olizeii/cockautomat/(commit log)

2026-10-17 Boxautomat 2.0: Arduino-Sketch, robuste Python-GUI, Installer und Tests
    - Arduino: MPU-6050 Schlagerkennung mit Peak-Fenster, Sperrzeit und Schwerkraft-Kompensation
    - Python: Zustandsautomat, Video-Loop mit Standbild beim Ergebnis, Ready-Overlay
    - USB-Verbindung im Hintergrund-Thread mit automatischem Reconnect
    - Logging in Datei statt print (behebt BrokenPipe/I/O-Abstürze)
    - install.sh, Starter, config.toml, pytest + GitHub Actions
    Claude-Session: https://claude.ai/code/session_01RWxiKtYJDPk6qvJvUJQxqo
    [app.py, boxautomat_sensor.ino, config.py, game.py, highscores.py, protocol.py, serial_link.py]
2026-10-17 Neues Idle-Video und überarbeitete Retro-Oberfläche
    - Idle-Video ersetzt (Pixel-Boxer im CRT-Rahmen, ohne Ton)
    - video_fit = contain: ganzes Video sichtbar, Titel/HUD in den Rändern
    - Ergebnis: LED-Panel mit Leuchten, Mosaik-Hintergrund mit Strahlen,
    Funken, segmentierter Kraftbalken mit Rekordmarke, Bewertung, Konfetti
    - Scoreboard im Synthwave-Look, letzter Schlag markiert
    - CRT-Overlay (Scanlines, Vignette), abschaltbar mit crt_effect
    - ArcadeClassic-Zeichen einzeln gesetzt (T/L-Laufweite)
2026-10-17 Einfachen Arduino-Sketch mit MPU6050-Bibliothek ergänzen
    Separate Alternative zu boxautomat_sensor: ±16 g, Ruhelage-Kalibrierung,
    Peak-Erkennung mit Sperrzeit, genau eine Zahl 1–999 pro Schlag.
2026-10-20 Sensor-Kalibrierung mit EEPROM und Kalibrier-Bildschirm
    Firmware 2.1:
    - Schwelle und 999-Punkte-Wert werden kalibriert und im EEPROM gespeichert
    - startet automatisch bei leerem EEPROM, per 6x Schalterkippen oder Befehl k
    - Ablauf Ruhe -> 3x leicht -> 3x hart, Ablehnung bei Bewegung / zu schwach
    - Übersteuerung (Achse am Anschlag) wird erkannt und gemeldet
    - Live-Stream, Abtastrate, Temperatur und Lage während der Kalibrierung
    App:
    - neue Protokollzeilen CFG und CAL, H mit Clip-Flag
    - Kalibrier-Bildschirm mit Live-Kurve, Messwerten, alten/neuen Werten
    und Warnung, wenn der Sensor näher ans Scharnier muss
    - Taste K startet/abbricht, mit --no-serial als Demo-Ablauf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
2026-11-01 Firmware 3.0: ESP32-S3 mit H3LIS331 (±100/200/400 g)
    - Sensor H3LIS331 direkt per I2C (1000 Hz, nur neue Messwerte), Messbereich RANGE_G
    - Kalibrierwerte im Flash (Preferences) statt EEPROM, Grenzen am Messbereich
    - Pins: I2C SDA 8 / SCL 9, Schalter GPIO 10; USB CDC ohne Blockieren
    - CFG meldet den Messbereich, '?' liefert READY/CFG/Schalter (natives USB resettet nicht)
    - App: Übersteuerung und Skala am gemeldeten Messbereich, Kurve logarithmisch,
    Messbereich statt Temperatur, ESP32-USB-IDs, fragt beim Verbinden '?'
    [app.py, boxautomat_sensor.ino, calibration.py, protocol.py, serial_link.py, ui.py]
2026-11-01 Firmware auf Seeed XIAO ESP32-S3 umstellen
    - Pins: SDA D4 (GPIO 5), SCL D5 (GPIO 6), Schalter D1 (GPIO 2)
    - H3LIS331-Adresse 0x18/0x19 wird automatisch erkannt
    - gelbe XIAO-LED ist low-aktiv
    - README: Verkabelung und Board für den XIAO
2026-11-01 Sensorrauschen glätten, Ruhe-Kalibrierung an H3LIS331 anpassen
    Der H3LIS331 springt bei 1000 Hz im Stillstand um bis zu ~2 g. Dadurch
    brach der Ruhe-Schritt immer mit "Bewegung erkannt" ab.
    - gleitender Mittelwert über 5 Messwerte (5 ms)
    - Bewegungsgrenze im Ruhe-Schritt 3 g, Schwellen 1,5x / 1,3x Rauschen
    - Live-Kurve zeigt auch in der ersten Ruhe-Sekunde echte Werte
2026-11-02 400 g Messbereich, kein Ersetzen durch Nachschwingen
    - RANGE_G standardmäßig 400 g (bei 200 g übersteuerten harte Schläge -> zu oft 999)
    - Firmware misst erst wieder, wenn der Sack nach der Sperrzeit 400 ms ruhig ist
    - App ignoriert Schläge innerhalb von min_hit_interval (3 s) nach dem letzten
2026-11-02 Bag oben/unten erkennen: Runterlassen zählt nicht als Schlag
    - Firmware vergleicht die Schwerkraftrichtung mit der Lage "unten" aus dem
    Ruhe-Schritt (gespeichert, Einstellungs-Version 3 -> einmal neu kalibrieren)
    - Schlag zählt nur, wenn der Bag vorher 400 ms unten und ruhig war,
    im Spiel und beim Kalibrieren; Ruhelage driftet nur, wenn der Bag unten ist
    - neue Meldung POS DOWN / POS UP (bei Änderung, alle 2 s und auf '?')
    - App: Zeile BAG im Kalibrier-Bildschirm, Hinweis "BAG IST OBEN",
    im Spiel "BAG RUNTERLASSEN" statt "HAU DRAUF" solange er oben ist
    [app.py, boxautomat_sensor.ino, calibration.py, protocol.py, ui.py]
2026-11-02 Schläge wieder erkennen: Scharf-Schalten nicht mehr vom Rauschen blockiert
    Bisher musste das Signal 400 ms ununterbrochen unter der halben Schwelle bleiben.
    Mit dem rauschenden H3LIS331 und leicht nachpendelndem Bag passierte das nie,
    deshalb wurde gar kein Schlag gezählt.
    - scharf, wenn der Bag 400 ms unten ist und nichts über die Schwelle geht
    - ignorierte Ausschläge werden gemeldet: CAL REJECT UP/SETTLE bzw. INFO im Log
    - Kalibrier-Bildschirm zeigt "BAG IST OBEN" / "ZU FRUEH BAG ERST AUSPENDELN LASSEN"
